leckardt/flukso/hardware/flukso1.3.htm

Stückliste exportiert aus /home/max/eagle/eagle/flukso/flukso1.3.sch am 11.12.10 17:20

Menge | Wert | Device | Bauteile
2 | | PINHD-1X10 | JP3, JP5
1 | 1.91k | R-EU_M1206 | R3
2 | 1u | C-EUC1206 | C4, C5
1 | 5.76k | R-EU_M1206 | R4
2 | 10k | R-EU_M1206 | R1, R9
1 | 16M | CRYSTALHC49S | Q1
2 | 22p | C-EUC1206 | C2, C3
1 | 37.4k | R-EU_M1206 | R7
1 | 64.9k | R-EU_M1206 | R6
7 | 100n | C-EUC1206 | C1, C6, C7, C8, C9, C11, C12
1 | 220u | CPOL-EU153CLV-0605 | C10
3 | 470 | R-EU_M1206 | R2, R5, R8
1 | ATMEGA644A | ATMEGA644A | IC1
1 | FT232RL | FT232RL | IC2
1 | ICSP | PINHD-2X3 | JP1
1 | JTAG | PINHD-2X5 | JP4
1 | L-1206AS 68N | WE-CBF_1206 | L1
1 | LOGGER | PINHD-1X4 | JP2
1 | MKDSN1,5/10-5,08 | MKDSN1,5/10-5,08 | X2
1 | PN61729-S | PN61729-S | X1
1 | blue | LEDSMT1206 | LED4
1 | green | LEDSMT1206 | LED2
1 | red | LEDSMT1206 | LED1
1 | yellow | LEDSMT1206 | LED3
