leckardt/flukso/hardware/board.png

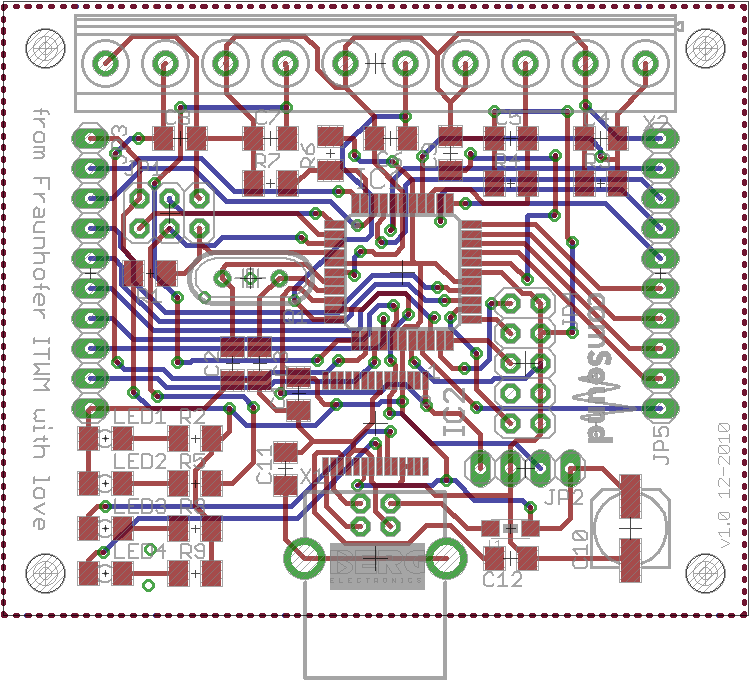
hardware/board.png
