leckardt/flukso/hardware/schematic.png

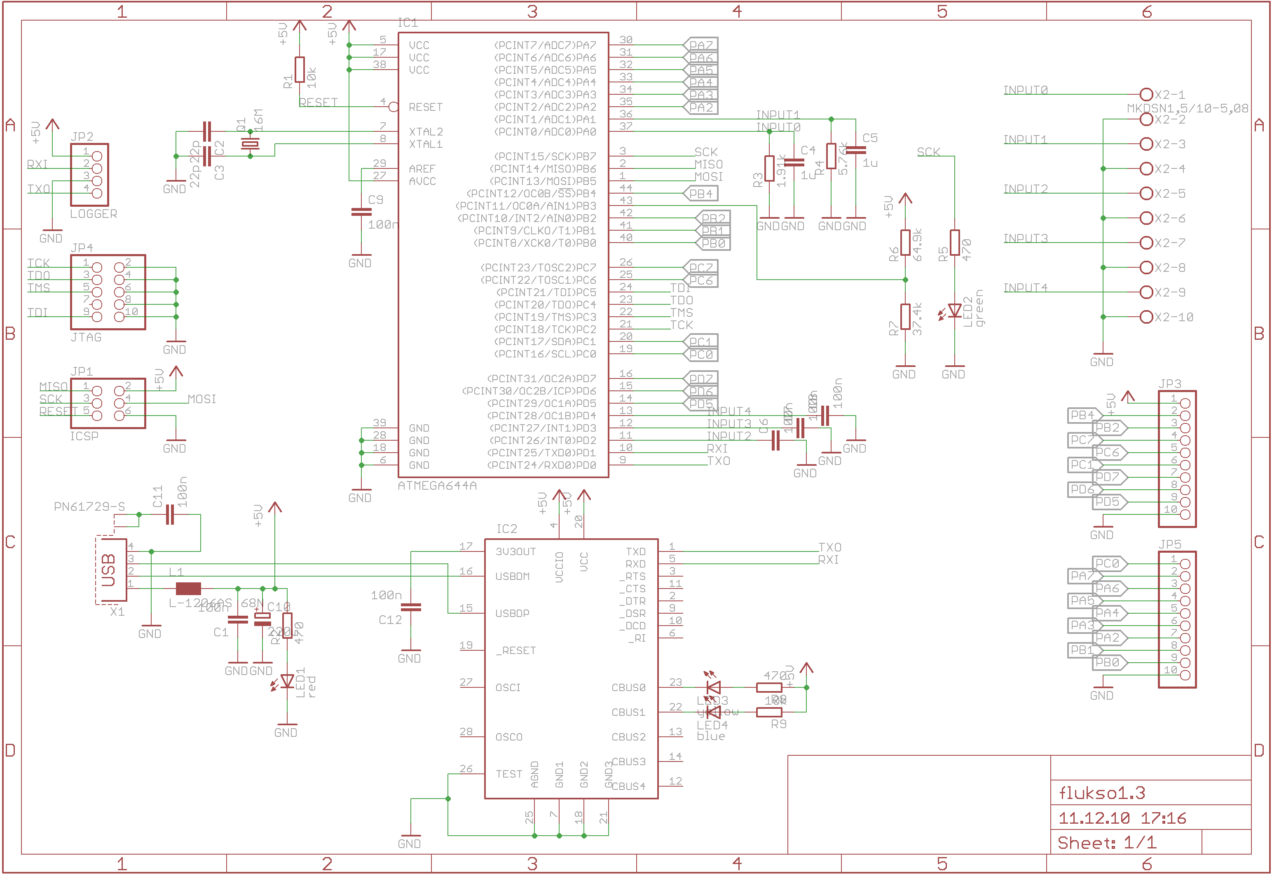
hardware/schematic.png
