leckardt/flukso/(commit log)

2011-01-08 changed sampling frequency from 2000kHz down to 125kHz, so we will get an higher resolution, so we can detect lower power levels correctly
    [main.c]
2011-02-17 removed carriage-return after each line of output
