leckardt/flukso/(notices)

Notices in the files:
software/main.h:
modify it under the terms of the GNU General Public License
